devKarthikRaj/project-nixie/Pictures/App LED Control.jpg

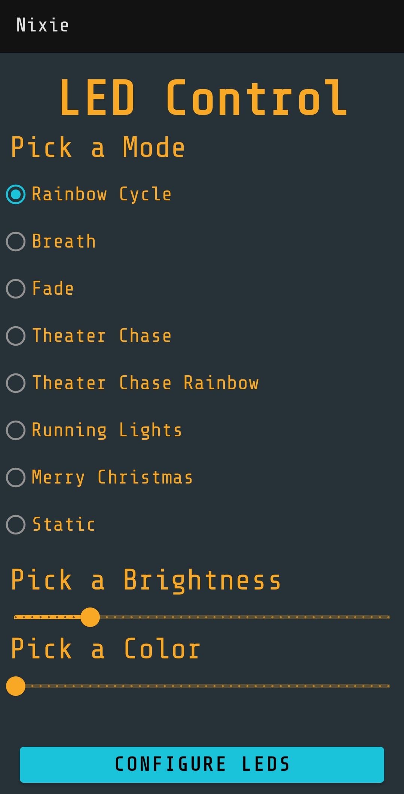
Pictures/App LED Control.jpg
