devKarthikRaj/project-nixie/Pictures/Clock Hardware Latest.jpeg

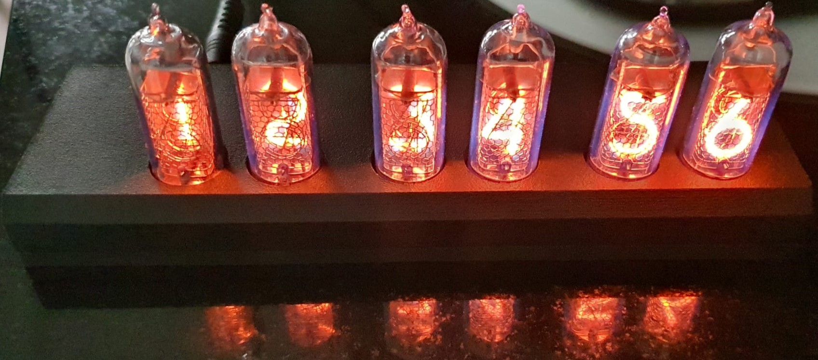
Pictures/Clock Hardware Latest.jpeg
