devKarthikRaj/project-nixie/Nixie Clock/Hardware/Nixie Clock v2.brd

## EAGLE design Nixie Clock/Hardware/Nixie Clock v2.brd (2022-05-31)

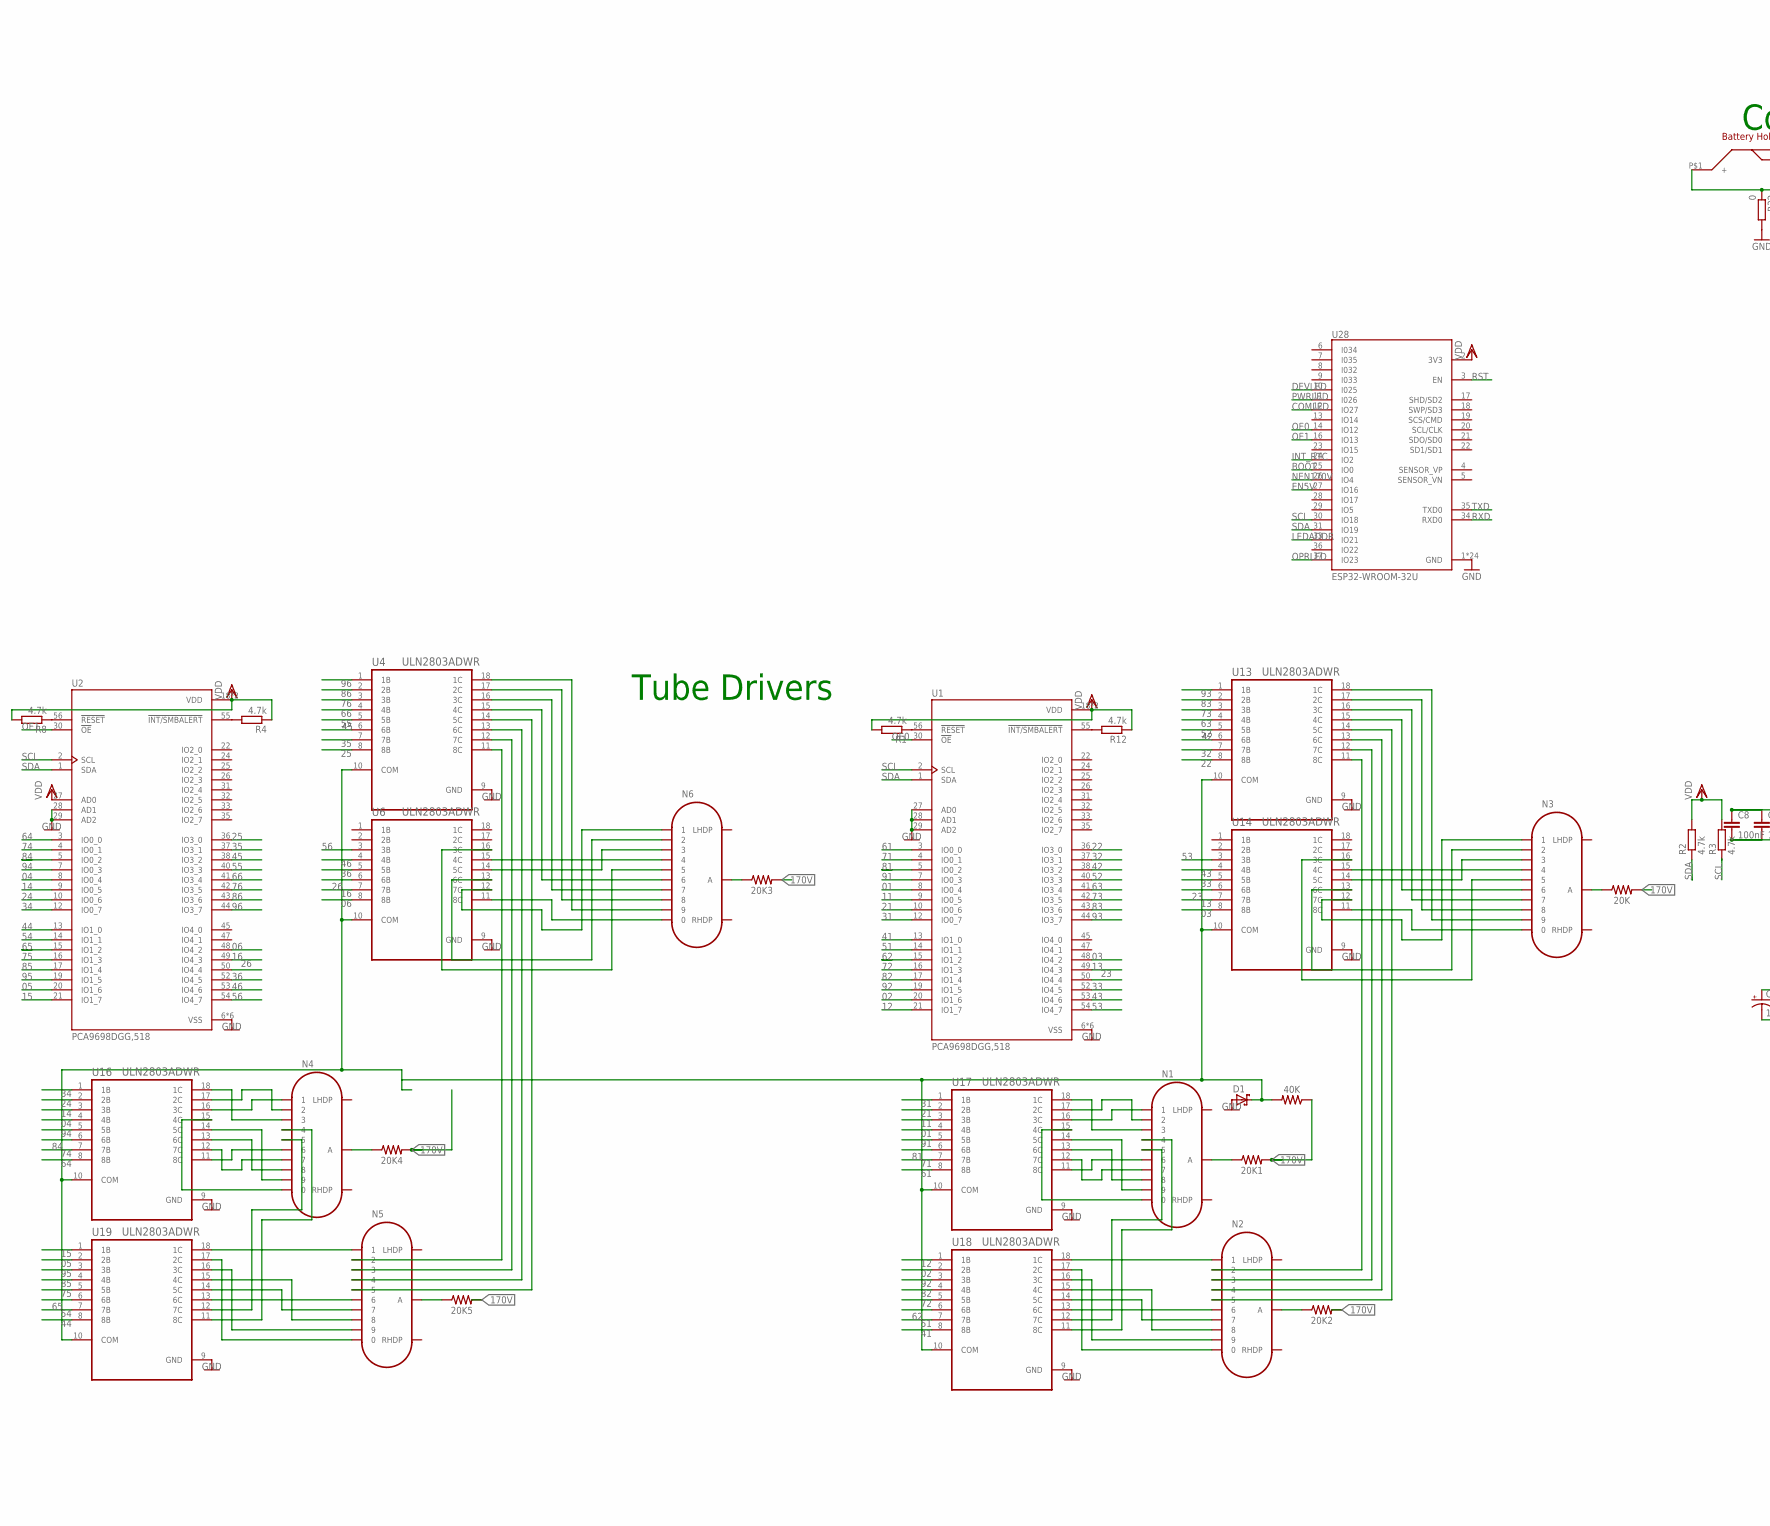
[picture p19: schematic Nixie Clock v2.sch, part in row 1, column 1]

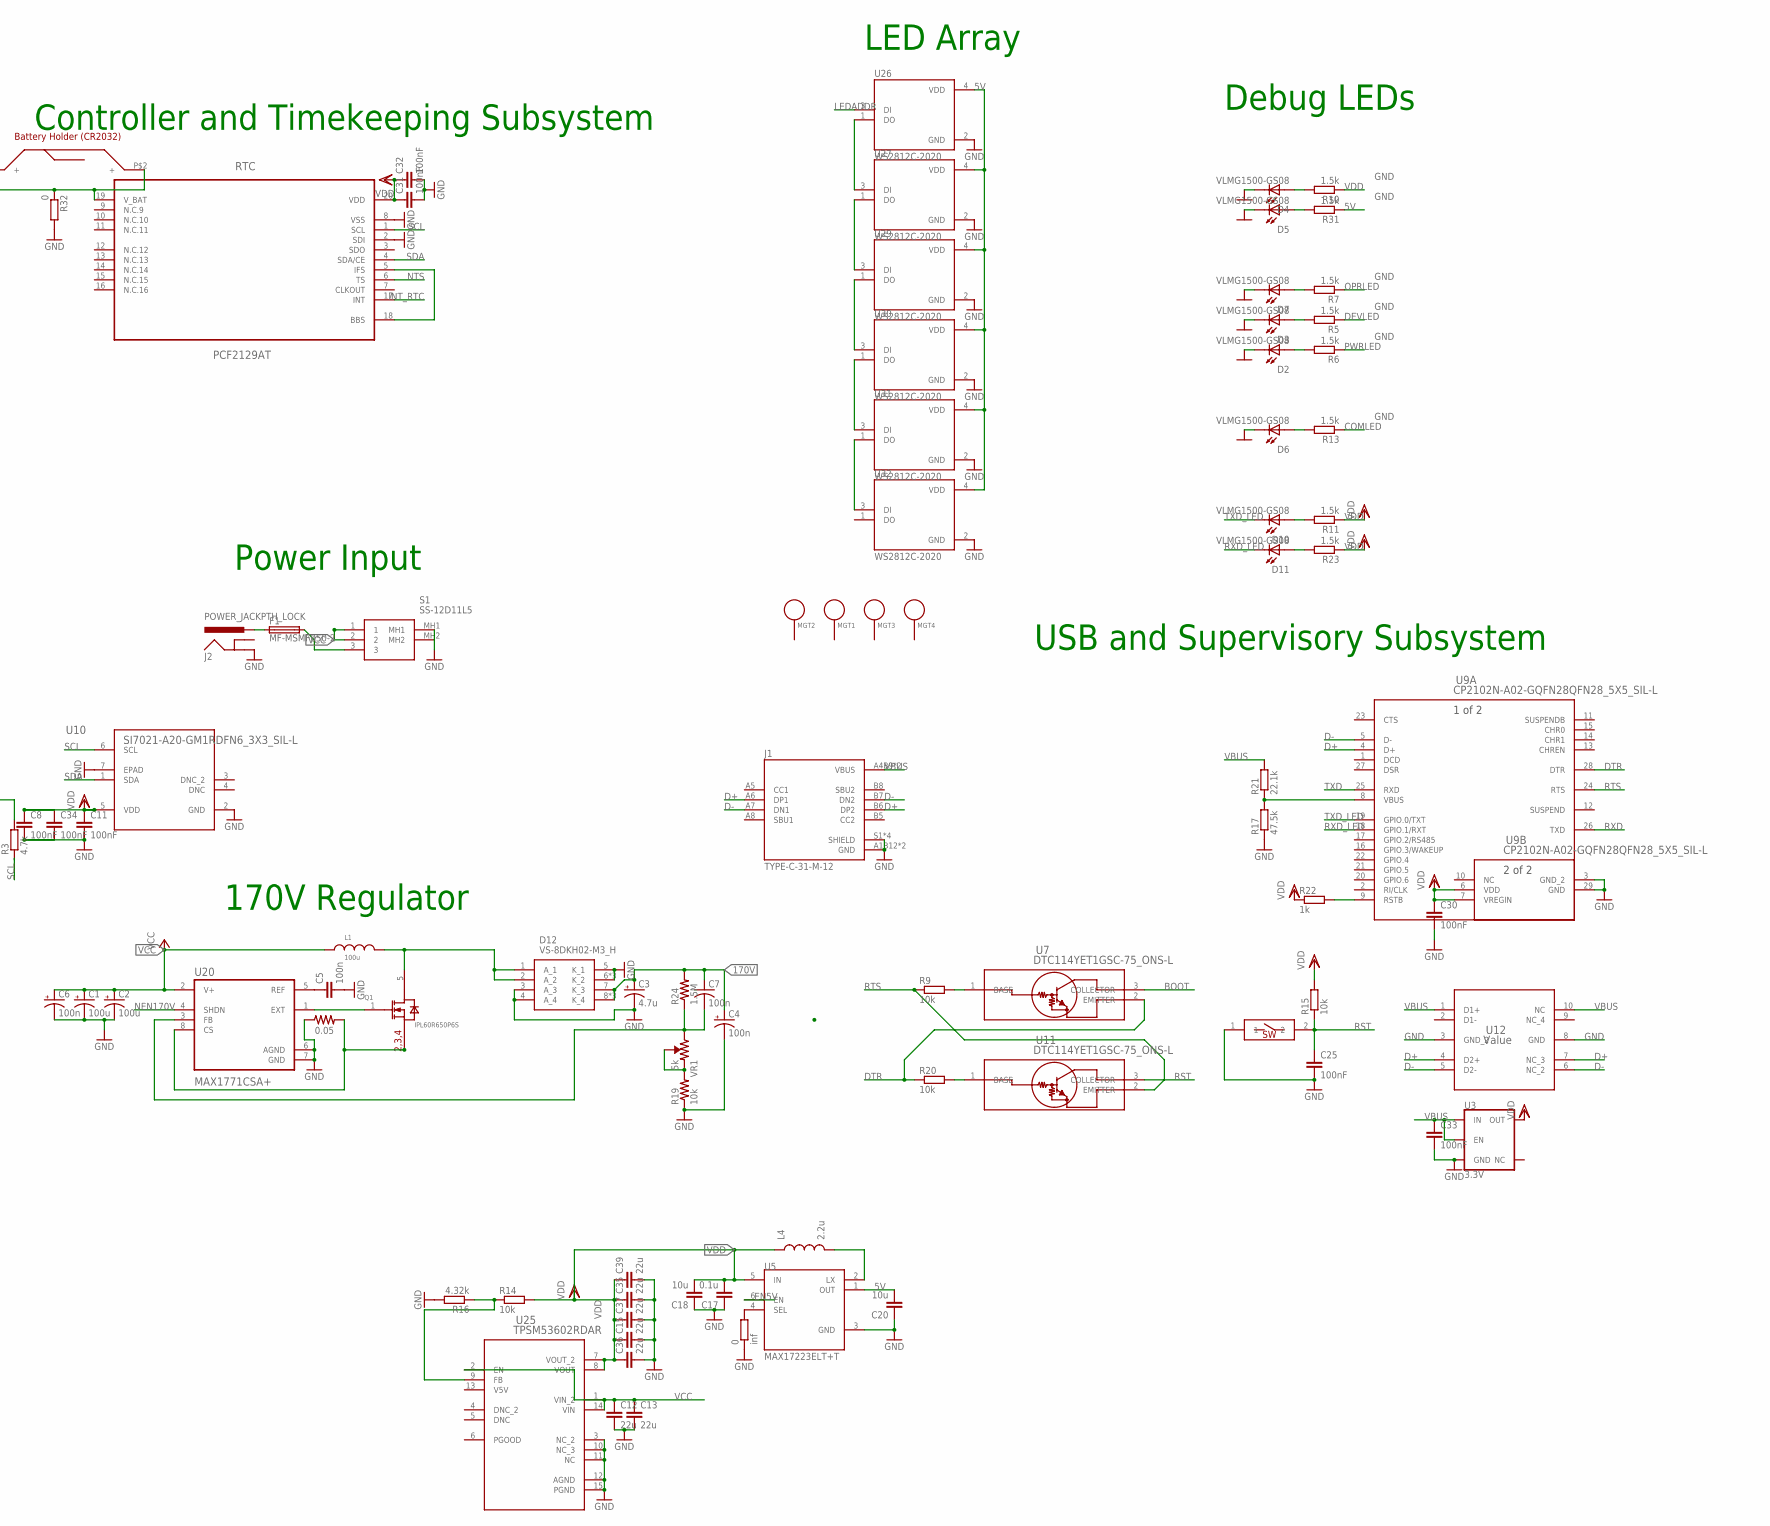
[picture p20: schematic Nixie Clock v2.sch, part in row 1, column 2]

Parts:
0: inf; R0402
0.05, 20K, 20K1, 20K2, 20K3, 20K4, 20K5, 40K: 0.05; 1210
C1, C2: 100u; E3,5-8
C3: 4.7u; E3,5-8
C4, C6: 100n; A/3216-18W
C5: 100n; C0402
C7: 100n; C1206K
C8, C11, C25, C30, C31, C32, C33, C34: 100nF; C0402
C12, C13, C15, C35, C36, C37, C39: 22u; C0603R
C17: 0.1u; C0402
C18, C20: 10u; C0402
D1: SCHOTTKY-DIODE; DIODE_SMB
D2, D3, D4, D5, D6, D7, D10, D11: VLMG1500-GS08; LEDC1005X35N
D12: VS-8DKH02-M3_H; VS8DKH02M3H
F1: MF-MSMF050-2; 1812
J1: TYPE-C-31-M-12; HRO_TYPE-C-31-M-12
J2: POWER_JACKPTH_LOCK; POWER_JACK_PTH_LOCK
L1: 100u; WE-PD_1260/1245/1280/1210
L4: 2.2u; L0603
MGT1, MGT2, MGT3, MGT4: BEAGLEBONEBLACK_MOUNTING_HOLE
N1, N2, N3, N4, N5, N6: IN-14
Q1: IPL60R650P6S; INF-PG-TSON-8-2
R1, R2, R3, R4, R8, R12: 4.7k; R0402
R5, R6, R7, R10, R11, R13, R23, R31: 1.5k; R0402
R9, R14, R15, R20: 10k; R0402
R16: 4.32k; R0402
R17: 47.5k; R0402
R19: 10k; M1206
R21: 22.1k; R0402
R22: 1k; R0402
R24: 1.5M; M1206
R32: 0; R0402
RESET: SMDSWITCH; RESC4217X170
S1: SS-12D11L5; SS12D11L5
U1, U2: PCA9698DGG,518; SOP50P810X120-56N
U3: 3.3V; SOT23-5
U4, U6, U13, U14, U16, U17, U18, U19: ULN2803ADWR; SOIC127P1030X265-18N
U5: MAX17223ELT+T; PSON65P200X200X80-6N
U7, U11: DTC114YET1GSC-75_ONS-L; SC-75_ONS-L
U9: CP2102N-A02-GQFN28QFN28_5X5_SIL-L; QFN28_5X5_SIL-L
U10: SI7021-A20-GM1RDFN6_3X3_SIL-L; DFN6_3X3_SIL-L
U12: Value; DQA0010A
U20: MAX1771CSA+; SOIC127P600X175-8N
U25: TPSM53602RDAR; B3QFN15_RDA_TEX
U26, U27, U29, U30, U31, U32: WS2812C-2020; LED_WS2812C-2020
U28: ESP32-WROOM-32U; XCVR_ESP32-WROOM-32U
U$1: PCF2129AT
U$2: HOLDER
VR1: 5k; TRIMPOT-SMD-3MM-CLOSED

Connections:
01: U1.8 (IO0_4), U17.4 (4B)
02: U1.20 (IO1_6), U18.2 (2B)
03: U1.48 (IO4_2), U14.8 (8B)
04: U2.8 (IO0_4), U16.4 (4B)
05: U2.20 (IO1_6), U19.2 (2B)
5V: C20.2, R31.1, U5.1 (OUT), U26.4 (VDD), U27.4 (VDD), U29.4 (VDD), U30.4 (VDD), U31.4 (VDD), U32.4 (VDD)
06: U2.48 (IO4_2), U6.8 (8B)
11: U1.9 (IO0_5), U17.3 (3B)
12: U1.21 (IO1_7), U18.1 (1B)
13: U1.49 (IO4_3), U14.7 (7B)
14: U2.9 (IO0_5), U16.3 (3B)
15: U2.21 (IO1_7), U19.1 (1B)
16: U2.49 (IO4_3), U6.7 (7B)
21: U1.10 (IO0_6), U17.2 (2B)
22: U1.36 (IO3_0), U13.8 (8B)
23: U1.50 (IO4_4), U14.6 (6B)
24: U2.10 (IO0_6), U16.2 (2B)
25: U2.36 (IO3_0), U4.8 (8B)
26: U2.50 (IO4_4), U6.6 (6B)
31: U1.12 (IO0_7), U17.1 (1B)
32: U1.37 (IO3_1), U13.7 (7B)
33: U1.52 (IO4_5), U14.5 (5B)
34: U2.12 (IO0_7), U16.1 (1B)
35: U2.37 (IO3_1), U4.7 (7B)
36: U2.52 (IO4_5), U6.5 (5B)
41: U1.13 (IO1_0), U18.8 (8B)
42: U1.38 (IO3_2), U13.6 (6B)
43: U1.53 (IO4_6), U14.4 (4B)
44: U2.13 (IO1_0), U19.8 (8B)
45: U2.38 (IO3_2), U4.6 (6B)
46: U2.53 (IO4_6), U6.4 (4B)
51: U1.14 (IO1_1), U18.7 (7B)
52: U1.40 (IO3_3), U13.5 (5B)
53: U1.54 (IO4_7), U14.3 (3B)
54: U2.14 (IO1_1), U19.7 (7B)
55: U2.40 (IO3_3), U4.5 (5B)
56: U2.54 (IO4_7), U6.3 (3B)
61: U1.3 (IO0_0), U17.8 (8B)
62: U1.15 (IO1_2), U18.6 (6B)
63: U1.41 (IO3_4), U13.4 (4B)
64: U2.3 (IO0_0), U16.8 (8B)
65: U2.15 (IO1_2), U19.6 (6B)
66: U2.41 (IO3_4), U4.4 (4B)
71: U1.4 (IO0_1), U17.7 (7B)
72: U1.16 (IO1_3), U18.5 (5B)
73: U1.42 (IO3_5), U13.3 (3B)
74: U2.4 (IO0_1), U16.7 (7B)
75: U2.16 (IO1_3), U19.5 (5B)
76: U2.42 (IO3_5), U4.3 (3B)
81: U1.5 (IO0_2), U17.6 (6B)
82: U1.17 (IO1_4), U18.4 (4B)
83: U1.43 (IO3_6), U13.2 (2B)
84: U2.5 (IO0_2), U16.6 (6B)
85: U2.17 (IO1_4), U19.4 (4B)
86: U2.43 (IO3_6), U4.2 (2B)
91: U1.7 (IO0_3), U17.5 (5B)
92: U1.19 (IO1_5), U18.3 (3B)
93: U1.44 (IO3_7), U13.1 (1B)
94: U2.7 (IO0_3), U16.5 (5B)
95: U2.19 (IO1_5), U19.3 (3B)
96: U2.44 (IO3_7), U4.1 (1B)
170V: 20K.2, 20K1.2, 20K2.2, 20K3.2, 20K4.2, 20K5.2, 40K.1, C3.+, C4.+, C7.1, D12.7 (K_3), D12.8 (K_4), D12.9 (K_4), D12.12 (K_4), R24.2
BOOT: U7.3 (COLLECTOR), U28.25 (IO0)
COMLED: R13.1, U28.12 (IO27)
D+: J1.A6 (DP1), J1.B6 (DP2), U9.4 (D+), U12.4 (D2+), U12.7 (NC_3)
D-: J1.A7 (DN1), J1.B7 (DN2), U9.5 (D-), U12.5 (D2-), U12.6 (NC_2)
DEVLED: R5.1, U28.10 (I025)
DTR: R20.1, U7.2 (EMITTER), U9.28 (DTR)
EN5V: U5.6 (EN), U28.27 (IO16)
GND: 0.1, 0.05.1, C1.-, C2.-, C3.-, C4.-, C5.2, C6.-, C8.2, C11.2, C12.2, C13.2, C15.2, C17.1, C18.1, C20.1, C25.2, C30.2, C31.2, C32.2, C33.2, C34.2, C35.2, C36.2, C37.2, C39.2, D1.A (C), D2.2, D3.2, D4.2, D5.2, D6.2, D7.2, D12.3 (A_3), D12.4 (A_4), D12.5 (K_1), D12.6 (K_2), D12.10 (K_2), D12.11 (K_2), J1.A1B12 (GND), J1.B1A12 (GND), J1.S1 (SHIELD), J1.S2 (SHIELD), J1.S3 (SHIELD), J1.S4 (SHIELD), J2.GND, R16.2, R17.1, R19.1, R32.2, RESET.1, S1.MH1, S1.MH2, U1.6 (VSS), U1.11 (VSS), U1.23 (VSS), U1.27 (AD0), U1.28 (AD1), U1.29 (AD2), U1.34 (VSS), U1.39 (VSS), U1.51 (VSS), U2.6 (VSS), U2.11 (VSS), U2.23 (VSS), U2.28 (AD1), U2.29 (AD2), U2.34 (VSS), U2.39 (VSS), U2.51 (VSS), U3.2 (GND), U4.9 (GND), U5.3 (GND), U6.9 (GND), U9.3 (GND_2), U9.29 (GND), U10.2 (GND), U10.7 (EPAD), U12.3 (GND_2), U12.8 (GND), U13.9 (GND), U14.9 (GND), U16.9 (GND), U17.9 (GND), U18.9 (GND), U19.9 (GND), U20.6 (AGND), U20.7 (GND), U25.3 (NC_2), U25.10 (NC_3), U25.11 (NC), U25.12 (AGND), U25.15 (PGND), U26.2 (GND), U27.2 (GND), U28.1 (GND), U28.15 (GND), U28.38 (GND), U28.G.1 (GND), U28.G.2 (GND), U28.G.4 (GND), U28.G.5 (GND), U28.G.6 (GND), U28.G.7 (GND), U28.G.8 (GND), U28.G.9 (GND), U28.G.10 (GND), U28.G.11 (GND), U28.G.12 (GND), U28.G.13 (GND), U28.G.14 (GND), U28.G.15 (GND), U28.G.16 (GND), U28.G.17 (GND), U28.G.18 (GND), U28.G.19 (GND), U28.G.20 (GND), U28.G.21 (GND), U28.G.22 (GND), U29.2 (GND), U30.2 (GND), U31.2 (GND), U32.2 (GND), U$1.2 (SDI), U$1.8 (VSS)
INT_RTC: U28.24 (IO2), U$1.17 (INT)
LEDADDR: U26.3 (DI), U28.33 (IO21)
unnamed: F1.1, J2.PWR
unnamed: C5.1, U20.5 (REF)
unnamed: 20K1.1, N1.A
unnamed: Q1.1 (GATE), U20.1 (EXT)
unnamed: 0.05.2, Q1.2 (SOURCE), Q1.3 (SOURCE), Q1.4 (SOURCE), U20.8 (CS)
unnamed: D12.1 (A_1), D12.2 (A_2), L1.2, Q1.5 (DRAIN)
unnamed: N2.0, U18.17 (2C)
unnamed: N2.9, U18.16 (3C)
unnamed: 20K2.1, N2.A
unnamed: R19.2, VR1.1 (CCW), VR1.2 (WIPER)
unnamed: C7.2, R24.1, U20.3 (FB), VR1.3 (CW)
unnamed: N2.8, U18.15 (4C)
unnamed: N2.7, U18.14 (5C)
unnamed: N1.5, U18.12 (7C)
unnamed: 20K.1, N3.A
unnamed: N2.6, U18.13 (6C)
unnamed: 0.2, U5.4 (SEL)
unnamed: D3.1, R5.2
unnamed: D7.1, R7.2
unnamed: L4.2, U5.2 (LX)
unnamed: 20K4.1, N4.A
unnamed: N2.1, U18.18 (1C)
unnamed: R17.2, R21.1, U9.8 (VBUS)
unnamed: D2.1, R6.2
unnamed: D4.1, R10.2
unnamed: D5.1, R31.2
unnamed: D6.1, R13.2
unnamed: N2.2, U13.11 (8C)
unnamed: R20.2, U11.1 (BASE)
unnamed: R9.2, U7.1 (BASE)
unnamed: N1.6, U17.11 (8C)
unnamed: N1.7, U17.12 (7C)
unnamed: R22.2, U9.9 (RSTB)
unnamed: D10.1, R11.2
unnamed: D11.1, R23.2
unnamed: F1.2, S1.3
unnamed: N1.8, U17.13 (6C)
unnamed: N1.9, U17.14 (5C)
unnamed: N1.0, U17.15 (4C)
unnamed: N1.1, U17.16 (3C)
unnamed: N1.2, U17.17 (2C)
unnamed: N1.3, U17.18 (1C)
unnamed: N2.3, U13.12 (7C)
unnamed: N1.4, U18.11 (8C)
unnamed: N2.4, U13.13 (6C)
unnamed: N2.5, U13.14 (5C)
unnamed: N3.6, U13.15 (4C)
unnamed: N3.7, U13.16 (3C)
unnamed: N3.8, U13.17 (2C)
unnamed: N3.9, U13.18 (1C)
unnamed: N3.0, U14.11 (8C)
unnamed: N3.1, U14.12 (7C)
unnamed: N3.2, U14.13 (6C)
unnamed: N3.3, U14.14 (5C)
unnamed: N3.4, U14.15 (4C)
unnamed: N3.5, U14.16 (3C)
unnamed: R4.2, U2.55 (!INT/SMBALERT)
unnamed: N4.6, U16.11 (8C)
unnamed: N4.7, U16.12 (7C)
unnamed: N4.8, U16.13 (6C)
unnamed: N4.9, U16.14 (5C)
unnamed: N4.0, U16.15 (4C)
unnamed: N4.1, U16.16 (3C)
unnamed: N4.2, U16.17 (2C)
unnamed: 40K.2, D1.C (A), U4.10 (COM), U6.10 (COM), U13.10 (COM), U14.10 (COM), U16.10 (COM), U17.10 (COM), U18.10 (COM), U19.10 (COM)
unnamed: N4.3, U16.18 (1C)
unnamed: N4.4, U19.11 (8C)
unnamed: N4.5, U19.12 (7C)
unnamed: N5.0, U19.17 (2C)
unnamed: N5.9, U19.16 (3C)
unnamed: N5.8, U19.15 (4C)
unnamed: N5.7, U19.14 (5C)
unnamed: N5.6, U19.13 (6C)
unnamed: N5.1, U19.18 (1C)
unnamed: N5.2, U4.11 (8C)
unnamed: N5.3, U4.12 (7C)
unnamed: N5.4, U4.13 (6C)
unnamed: N5.5, U4.14 (5C)
unnamed: N6.6, U4.15 (4C)
unnamed: N6.7, U4.16 (3C)
unnamed: N6.8, U4.17 (2C)
unnamed: N6.9, U4.18 (1C)
unnamed: N6.0, U6.11 (8C)
unnamed: N6.1, U6.12 (7C)
unnamed: N6.2, U6.13 (6C)
unnamed: N6.3, U6.14 (5C)
unnamed: N6.4, U6.15 (4C)
unnamed: N6.5, U6.16 (3C)
unnamed: R14.1, R16.1, U25.9 (FB)
unnamed: 20K5.1, N5.A
unnamed: 20K3.1, N6.A
unnamed: R1.1, U1.56 (!RESET)
unnamed: R12.2, U1.55 (!INT/SMBALERT)
unnamed: R32.1, U$1.19 (V_BAT), U$2.P$1, U$2.P$2
unnamed: R8.1, U2.56 (!RESET)
unnamed: U26.1 (DO), U27.3 (DI)
unnamed: U27.1 (DO), U29.3 (DI)
unnamed: U29.1 (DO), U30.3 (DI)
unnamed: U30.1 (DO), U31.3 (DI)
unnamed: U31.1 (DO), U32.3 (DI)
unnamed: U$1.5 (IFS), U$1.18 (BBS)
NEN170V: U20.4 (SHDN), U28.26 (IO4)
NTS: U$1.6 (TS)
OE0: U1.30 (!OE), U28.14 (IO12)
OE1: U2.30 (!OE), U28.16 (IO13)
OPRLED: R7.1, U28.37 (IO23)
PWRLED: R6.1, U28.11 (I026)
RST: C25.1, R15.1, RESET.2, U11.3 (COLLECTOR), U28.3 (EN)
RTS: R9.1, U9.24 (RTS), U11.2 (EMITTER)
RXD: U9.26 (TXD), U28.34 (RXD0)
RXD_LED: D11.2, U9.18 (GPIO.1/RXT)
SCL: R3.1, U1.2 (SCL), U2.2 (SCL), U10.6 (SCL), U28.30 (IO18), U$1.1 (SCL)
SDA: R2.1, U1.1 (SDA), U2.1 (SDA), U10.1 (SDA), U28.31 (IO19), U$1.4 (SDA/CE)
TXD: U9.25 (RXD), U28.35 (TXD0)
TXD_LED: D10.2, U9.19 (GPIO.0/TXT)
VBUS: C33.1, J1.A4B9 (VBUS), J1.B4A9 (VBUS), R21.2, U3.1 (IN), U3.3 (EN), U12.1 (D1+), U12.10 (NC)
VCC: C1.+, C2.+, C6.+, C12.1, C13.1, L1.1, S1.1, S1.2, U20.2 (V+), U25.1 (VIN_2), U25.2 (EN), U25.14 (VIN)
VDD: C8.1, C11.1, C15.1, C17.2, C18.2, C30.1, C31.1, C32.1, C34.1, C35.1, C36.1, C37.1, C39.1, L4.1, R1.2, R2.2, R3.2, R4.1, R8.2, R10.1, R11.1, R12.1, R14.2, R15.2, R22.1, R23.1, U1.18 (VDD), U1.46 (VDD), U2.18 (VDD), U2.27 (AD0), U2.46 (VDD), U3.5 (OUT), U5.5 (IN), U9.6 (VDD), U9.7 (VREGIN), U10.5 (VDD), U25.7 (VOUT_2), U25.8 (VOUT), U28.2 (3V3), U$1.20 (VDD)

Notes on the sheet:
Tube Drivers
Controller and Timekeeping Subsystem
LED Array
Debug LEDs
Power Input
170V Regulator
USB and Supervisory Subsystem

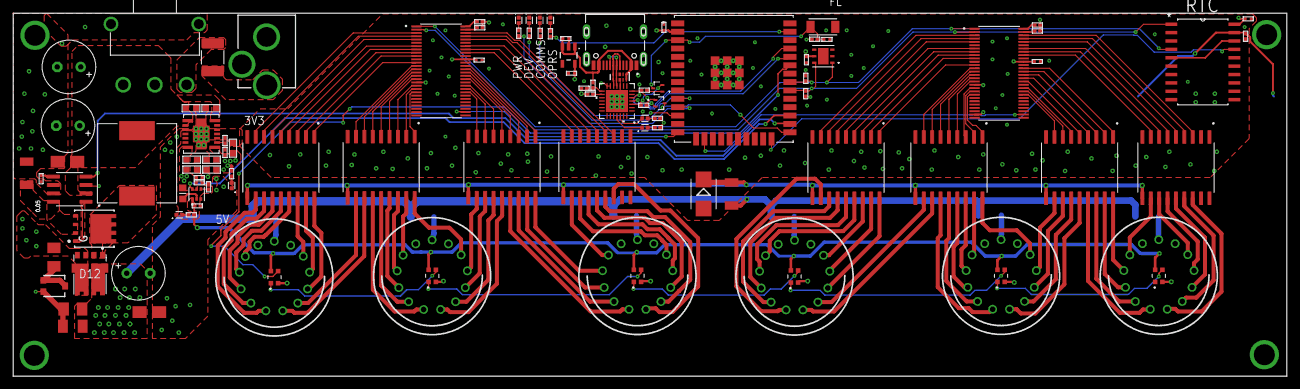
[picture p21: board Nixie Clock v2.brd from above]

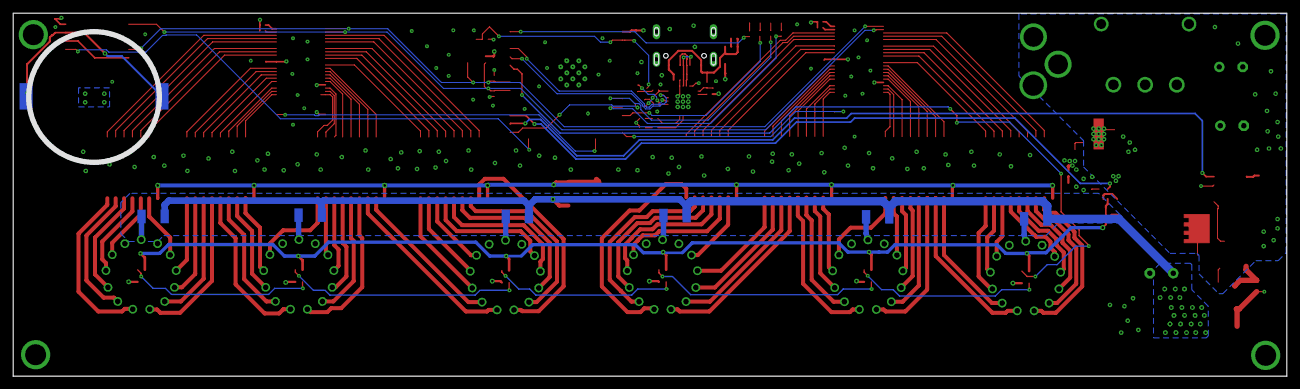
[picture p22: board Nixie Clock v2.brd from below]

Board: 4 copper layers, 193.0 x 55.0 mm, 116 parts (7 on the bottom side), 189 nets.
