devKarthikRaj/project-nixie/(commit log)

2021-11-17 Removed bt verification and bug fixes
    [Home.java]
2022-01-20 Added updated PCB files
    [Nixie Clock v2.brd, Nixie Clock v2.sch]
2022-03-03 Updated to use new Nixie driver library
2022-03-05 v2 Update
    [Nixie Clock v2.brd, Nixie Clock v2.sch, app_logo.xml]
2022-03-16 Restructured folders
    [Nixie Clock v2.brd, Nixie Clock v2.sch, app_logo.xml]
2022-03-16 Changed I2C clock speed
