devKarthikRaj/project-nixie/(notices)

Notices in the files:
parts and their libraries:
SparkFun-Resistors: Licensing: Creative Commons ShareAlike 4.0 International - https://creativecommons.org/licenses/by-sa/4.0
Wurth_Elektronik_Passive_rev18f: Copyright: Würth Elektronik
COPYRIGHT: Copyright (C) 2018 Accelerated Designs. All rights reserved
